dwt98/dr55sync/dr55syncVer2errata_git_sch.pdf

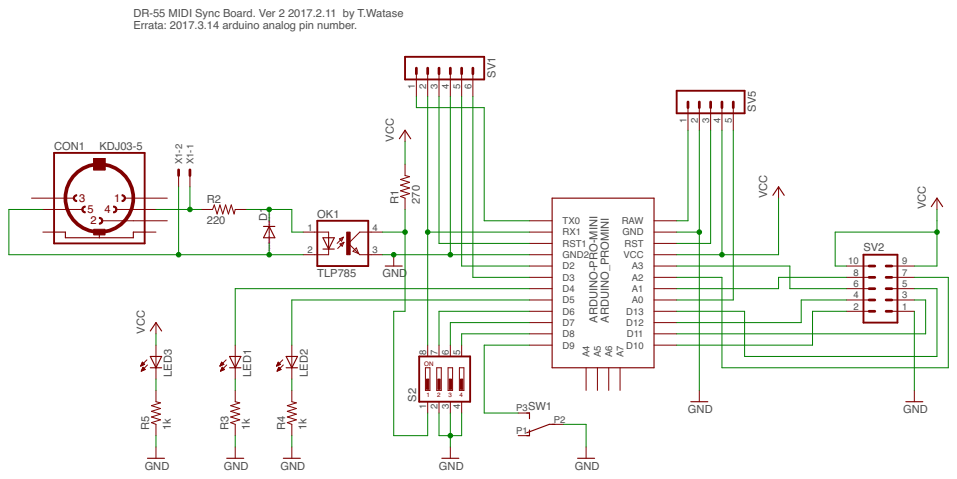
[picture p1: page 1]

SpiceOrder 1 SpiceOrder 2 DR-55 MIDI Sync Board. Ver 2 2017.2.11 by T.Watase Errata: 2017.3.14 arduino analog pin number. TLP785 270 220 1k1k1k VCC VCC GND GND GND GND GNDVCC GND VCC GND GND ARDUINO_PROMINI KDJ03-5 OK1 12 34 R1R2 R3 R4 R5 D1 LED1 LED2 LED3 SV2 2 1 4 3 6 5 8 7 10 9 SV5 12345 X1-1 X1-2 S2 8765 1234 SV1 123456 TX0 RX1 RST1 GND2 D2 D3 D4 D5 D6 D7 D8 D9 RAW GND RST VCCA3A2A1A0 D13 D12 D11 D10 A7A6A5A4 ARDUINO-PRO-MINI SW1 P2 P3P1 CON1 1 2 3 4 ON 1 2 3 5 4
