dwt98/dr55sync/(threads)

Thread 1 (2018-01-12):

Not playing when power connected

syproduction, 2018-01-12:
Device doesn't work at all unless i disconnect +7v (coming from DR55) from VIN on arduino.

And also i have to connect SHIELD pin from midi device to GND on Arduino. Without it it loses many messages.

Thread 4 (2019-02-15):

#include metro.h issue

mr-buttons, 2019-02-15:
hello dear git hub people

we are trying to this mod to the dr55, wile trying to write the code to the arduino ic the process fails and ther's an error ''#include metro.h'' ...
help would be much appreciated how to decode the error
thank you
 mr.buttons
