dwt98/dr55sync/(commit log)

2017-02-04 clock ledとnote ledを統合。Metroを導入。
2017-02-05 timerをMetroに置き換え。
2017-04-12 Bug fix: Omni off setting did not work. Revise comment.
    [Dr55_Sync.ino]
2017-08-01 スタート時のLEDテストを追加。Omni Modeの判定を修正。
2017-08-01 基板のバージョンでピン配置を変更。
2017-09-02 Add info of soldering points.
